donpivo/DeLight/README.md

Description: https://retronics.no/2024/05/17/diy-work-light-warning-light-emergency-light-morse-sos-flasher-for-dewalt-xr-batteries/
