donpivo/DeLight/Models/LED_Pentagon.stl

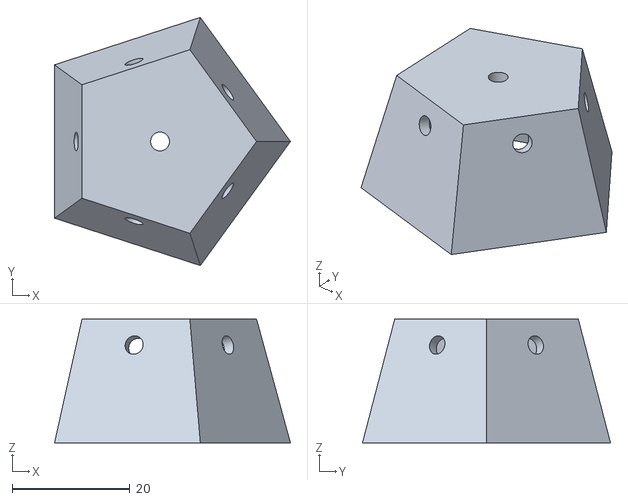
[picture p1: CAD file, 2024-05-17]
Models/LED_Pentagon.stl
40.0 x 42.1 x 21.0
