donpivo/DeLight/Schematic/LED_Plate/LED_Plate.step

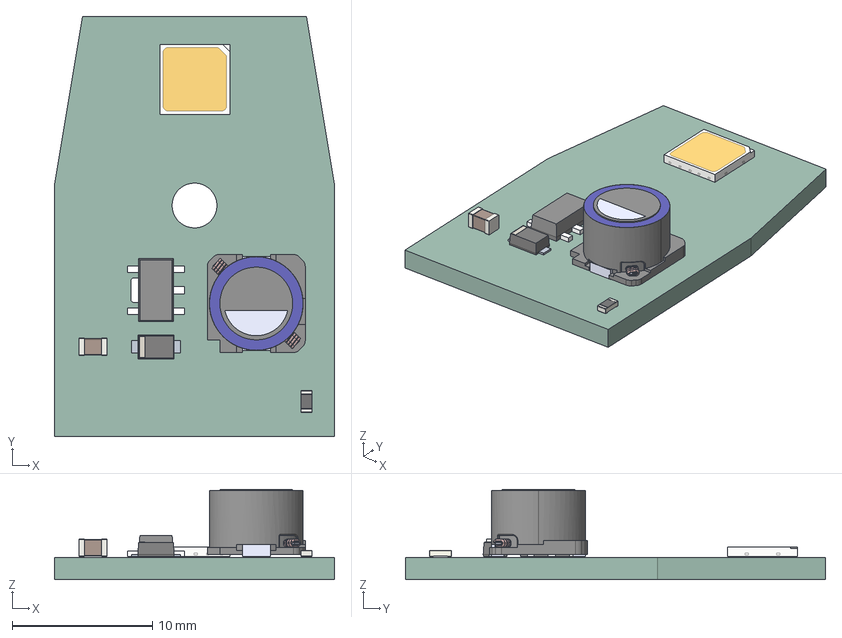
[picture p2: CAD file, 2024-05-17]
Schematic/LED_Plate/LED_Plate.step
20.0 x 30.0 x 6.45 mm
SLF7045T-101MR50-PF
AL8861Y-13
C_0805_2012Metric
R_0603_1608Metric
CQ assembly
GW Q9LR33_PM_20230222_geometry v1
LED_Plate PCB
