donpivo/DeLight/Models/EncoderCover.stl

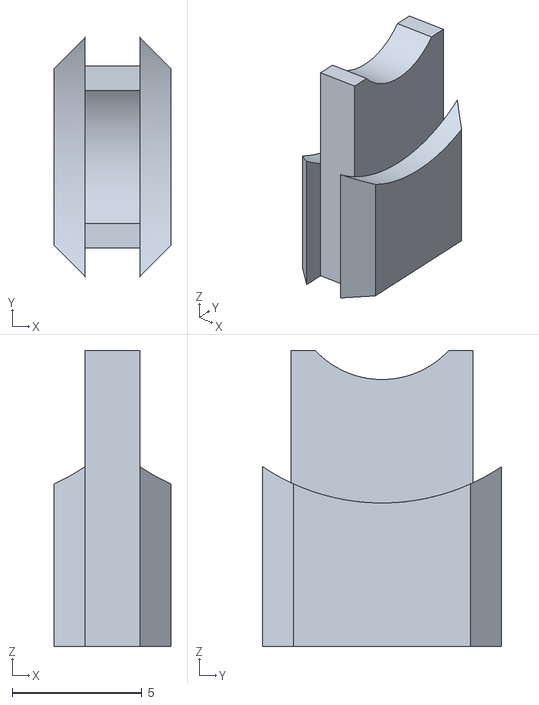
[picture p3: CAD file, 2024-05-17]
Models/EncoderCover.stl
4.50 x 9.20 x 11.4
