donpivo/DeLight/Models/Knob.stl

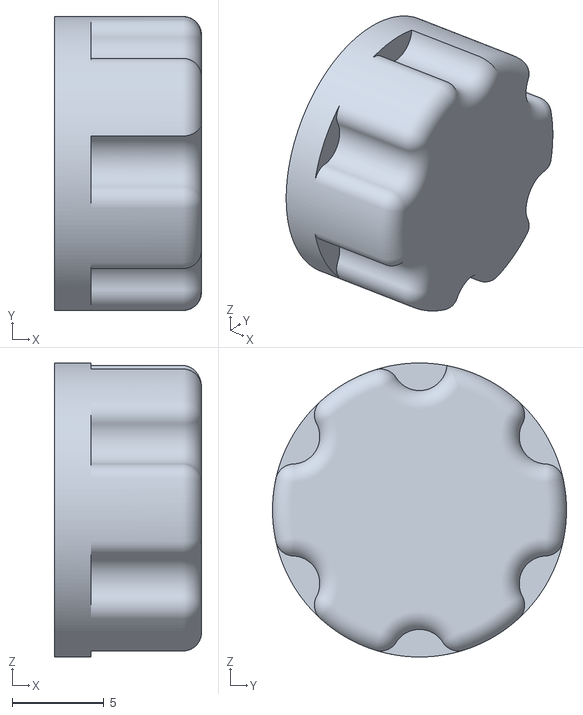
[picture p4: CAD file, 2024-05-17]
Models/Knob.stl
8.00 x 16.0 x 16.0
