donpivo/DeLight/Models/Lid.stl

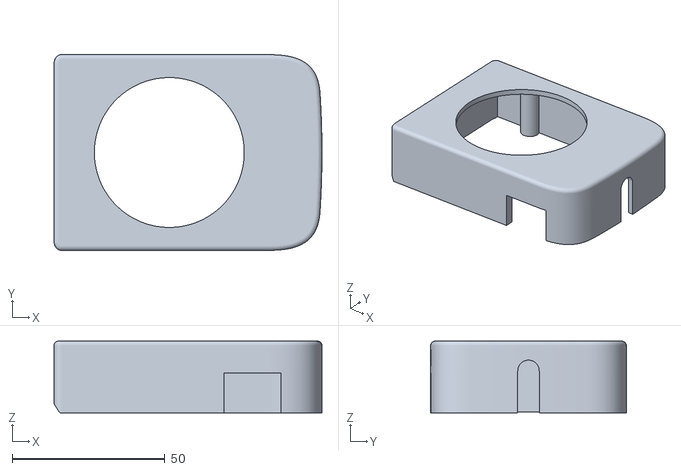
[picture p5: CAD file, 2024-05-17]
Models/Lid.stl
87.6 x 64.0 x 23.5
