donpivo/DeLight/Models/BattConn_Mid.stl

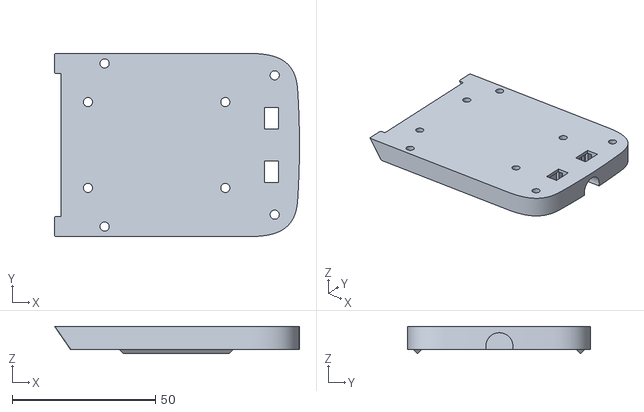
[picture p6: CAD file, 2024-05-17]
Models/BattConn_Mid.stl
85.6 x 64.0 x 9.50
