donpivo/DeLight/Schematic/LED_Plate/LED_Plate.kicad_pcb

## KiCad design Schematic/LED_Plate/LED_Plate.kicad_pcb (2024-05-17)

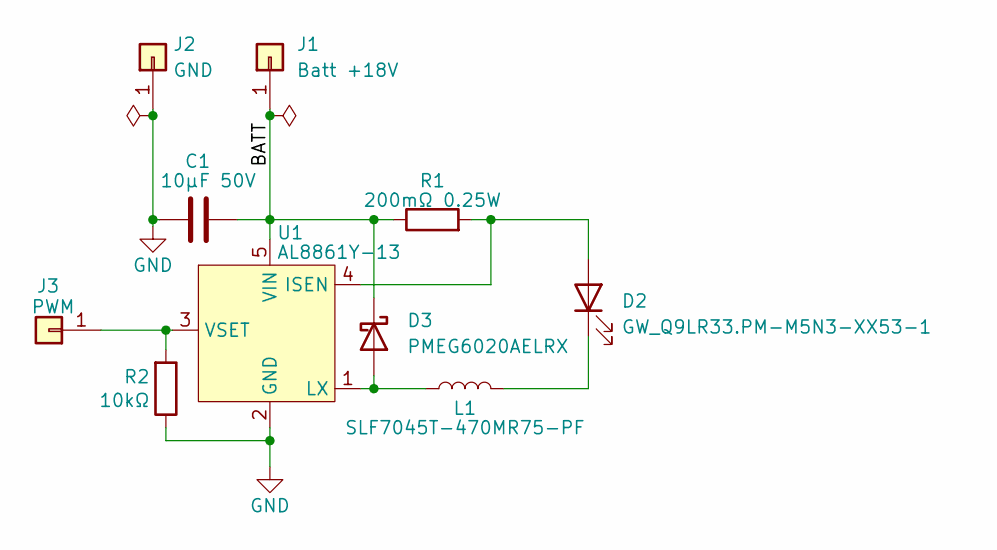
[picture p7: schematic LED_Plate.kicad_sch, DeLight LED Driver]

Parts:
C1: 10µF 50V; C_0805_2012Metric_Pad1.18x1.45mm_HandSolder
D2: GW_Q9LR33.PM-M5N3-XX53-1; LED_GW_Q9LR33.PM-M5N3-XX53-1
D3: PMEG6020AELRX; Nexperia_CFP3_SOD-123W
J1: Batt +18V; TestPoint_Pad_2.5x2.5mm
J2: GND; TestPoint_Pad_2.5x2.5mm
J3: PWM; TestPoint_Pad_2.5x2.5mm
L1: SLF7045T-470MR75-PF; SLF7032_7045
R1: 200mΩ 0.25W; R_1206_3216Metric_Pad1.30x1.75mm_HandSolder
R2: 10kΩ; R_0603_1608Metric_Pad0.98x0.95mm_HandSolder
U1: AL8861Y-13; SOT89-5

Connections:
/BATT: C1.2, D3.1 (K), J1.1, R1.1, U1.5 (VIN)
GND: C1.1, J2.1, R2.1, U1.2 (GND)
unnamed: D2.2 (A), R1.2, U1.4 (ISEN)
unnamed: D2.1 (K), L1.2
unnamed: D3.2 (A), L1.1, U1.1 (LX)
unnamed: J3.1, R2.2, U1.3 (VSET)

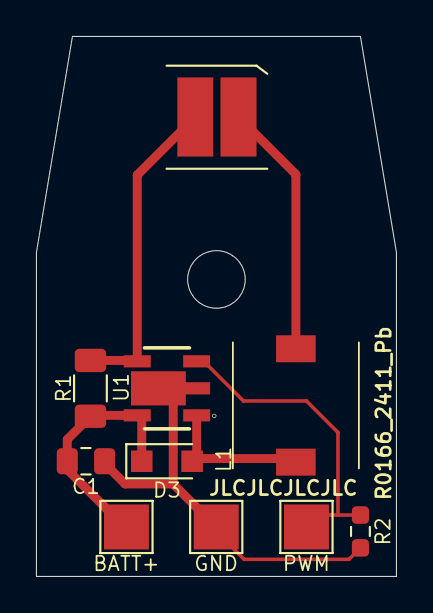
[picture p8: board LED_Plate.kicad_pcb from above]

Board: 2 copper layers, 20.0 x 30.0 mm, 10 parts (0 on the bottom side), 6 nets.
