donpivo/DeLight/Schematic/Controller/Controller.kicad_pcb

## KiCad design Schematic/Controller/Controller.kicad_pcb (2024-05-17)

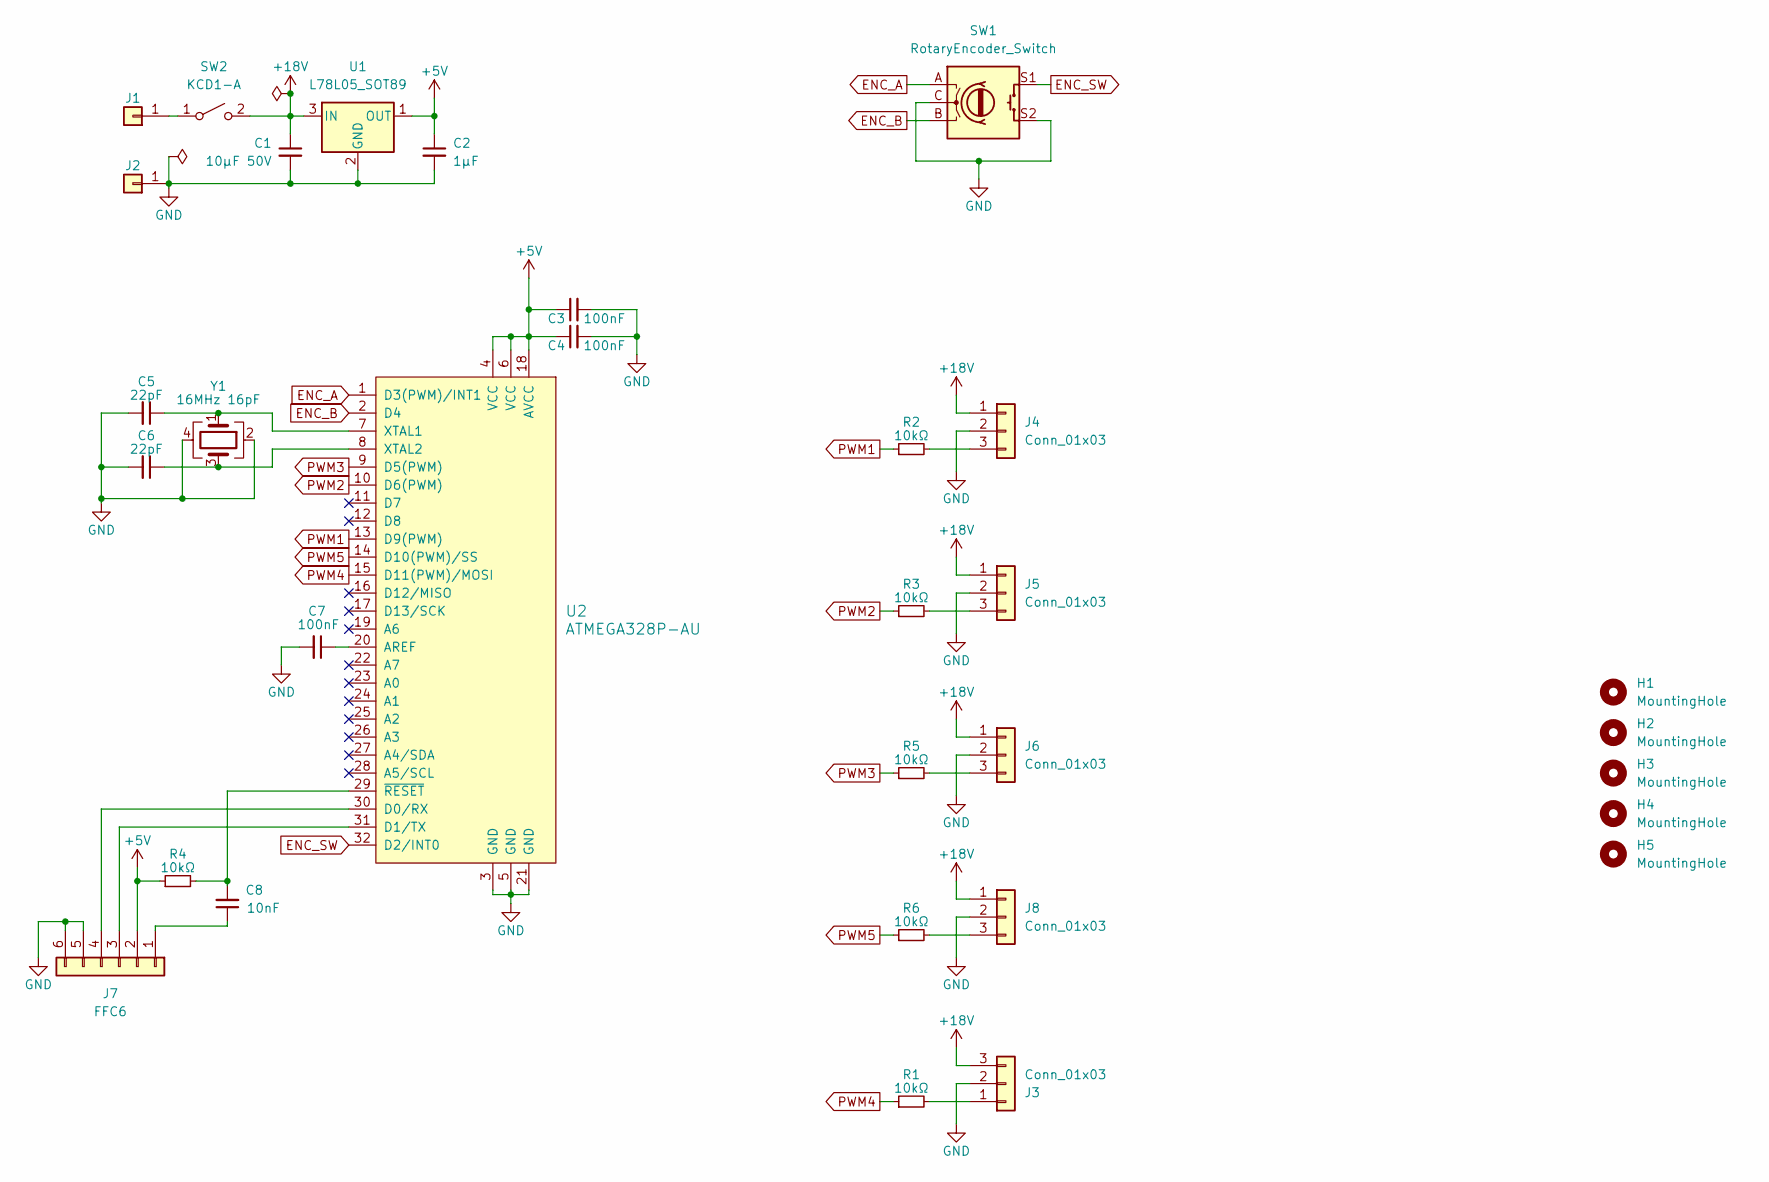
[picture p9: schematic Controller.kicad_sch, DeLight Omni Controller]

Parts:
C1: 10µF 50V; C_0805_2012Metric_Pad1.18x1.45mm_HandSolder
C2: 1µF; C_0805_2012Metric_Pad1.18x1.45mm_HandSolder
C3, C4, C7: 100nF; C_0603_1608Metric_Pad1.08x0.95mm_HandSolder
C5, C6: 22pF; C_0603_1608Metric_Pad1.08x0.95mm_HandSolder
C8: 10nF; C_0603_1608Metric_Pad1.08x0.95mm_HandSolder
H1, H2, H3, H4, H5: MountingHole; MountingHole_3.2mm_M3
J1, J2: Conn_01x01; TestPoint_THTPad_D3.0mm_Drill1.5mm
J3, J4, J5, J6, J8: Conn_01x03; Pads_3_2.5x2.5mm_5mmPitch
J7: FFC6; FFC_0527450697
R1, R2, R3, R4, R5, R6: 10kΩ; R_0603_1608Metric_Pad0.98x0.95mm_HandSolder
SW1: RotaryEncoder_Switch; PEC12R-2220F-S0024
SW2: KCD1-A; Pads_Dual_7x2mm_6.5mmPitch
U1: L78L05_SOT89; SOT-89-3
U2: ATMEGA328P-AU; TQFP-32_7x7mm_P0.8mm
Y1: 16MHz 16pF; Crystal_SMD_SeikoEpson_TSX3225-4Pin_3.2x2.5mm

Connections:
+5V: C2.1, C3.1, C4.1, J7.2, R4.1, U1.1 (OUT), U2.4 (VCC), U2.6 (VCC), U2.18 (AVCC)
+18V: C1.1, J3.3, J4.1, J5.1, J6.1, J8.1, SW2.2 (B), U1.3 (IN)
ENC_A: SW1.A, U2.1 (D3(PWM)/INT1)
ENC_B: SW1.B, U2.2 (D4)
ENC_SW: SW1.S1, U2.32 (D2/INT0)
GND: C1.2, C2.2, C3.2, C4.2, C5.2, C6.2, C7.2, J2.1, J3.2, J4.2, J5.2, J6.2, J7.5, J7.6, J8.2, SW1.C, SW1.S2, U1.2 (GND), U2.3 (GND), U2.5 (GND), U2.21 (GND), Y1.2, Y1.4
unnamed: J1.1, SW2.1 (A)
unnamed: J3.1, R1.2
unnamed: J4.3, R2.2
unnamed: J5.3, R3.2
unnamed: J6.3, R5.2
unnamed: C8.1, J7.1
unnamed: J7.3, U2.31 (D1/TX)
unnamed: J7.4, U2.30 (D0/RX)
unnamed: J8.3, R6.2
unnamed: C7.1, U2.20 (AREF)
unnamed: C5.1, U2.7 (XTAL1), Y1.1
unnamed: C6.1, U2.8 (XTAL2), Y1.3
unnamed: C8.2, R4.2, U2.29 (~RESET)
PWM1: R2.1, U2.13 (D9(PWM))
PWM2: R3.1, U2.10 (D6(PWM))
PWM3: R5.1, U2.9 (D5(PWM))
PWM4: R1.1, U2.15 (D11(PWM)/MOSI)
PWM5: R6.1, U2.14 (D10(PWM)/SS)

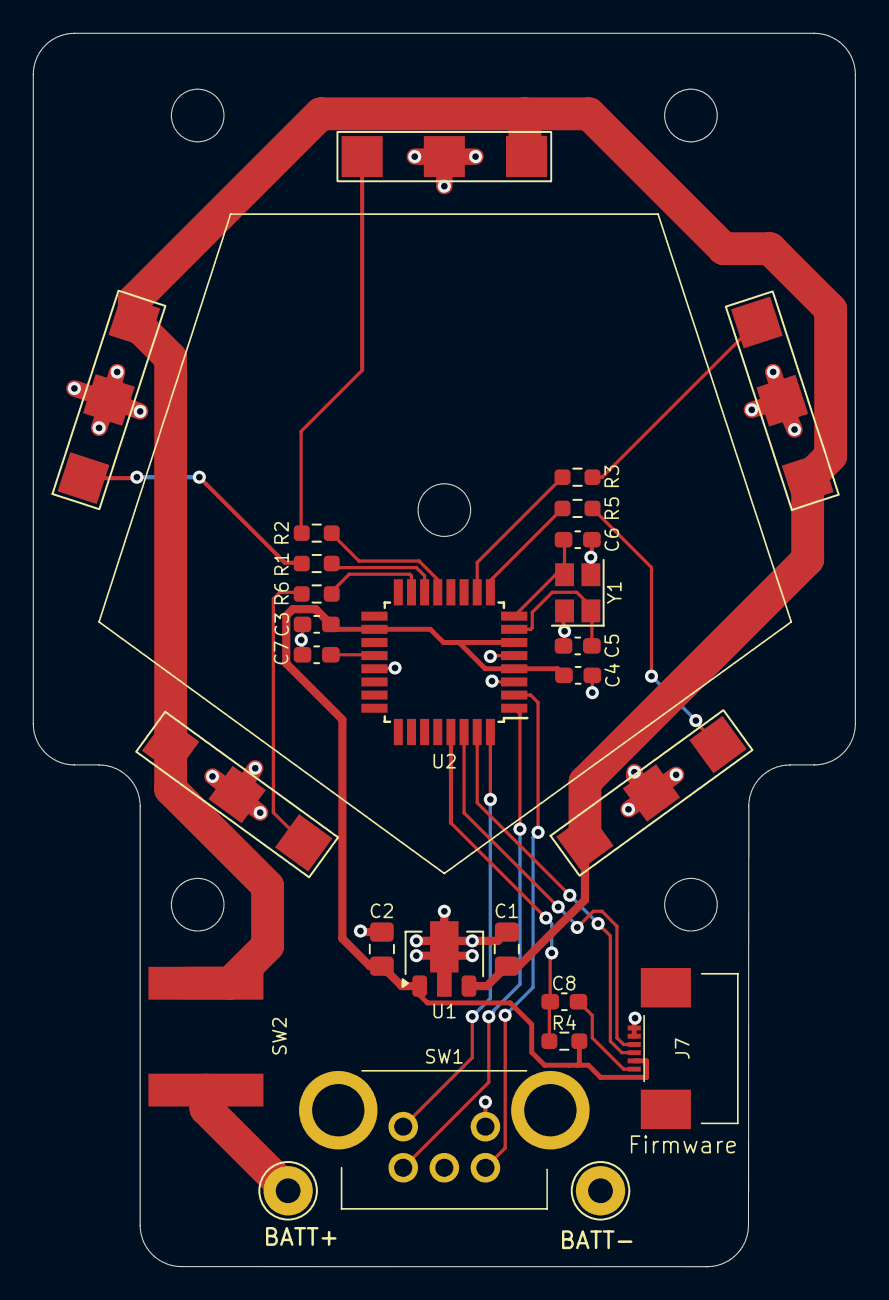
[picture p10: board Controller.kicad_pcb from above]

Board: 2 copper layers, 50.0 x 75.0 mm, 32 parts (0 on the bottom side), 24 nets.
